hilmirstraum/hoytalerProsjekt/notater.txt

tid for pause signal å bli regristert 110 milisekund

tid fra min til maks volum 4,5 sekunder

rød: pins på arduino
sort: pinst på bluethooth
rød enkel: kcom 

kommandoer
volume:...
next song
last song
appConnected
appDisconnected
stop ip				forteller at man skal stoppe å vise ip addressen på skjermen

play: 4
vol-: 5
vol+: 6
DN: 7
UP: 8
