hilmirstraum/hoytalerProsjekt/koblingsskjema.pptx

Skjerm

SDA

SCL

VCC

GND

Forsterker

+

OUT1

GND

IN1

IN2

+

+

OUT2

Ultralydsensor

Trig

Vcc

Echo

Gnd

Arduino Uno

9

8

5

4

1

Aref

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
Ioref

Reset

3,3V

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
Bluethootkort

Lin

GND

Rin

NA

Lout

GND

Rout

NA

GND

+VCC

+5V

GND

MIC-

MIC+

NA

KEY COM

PLAY

VOL-

VOL+

DN

LED2

LED1

GND

UP

Nodemcu 1.0

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
