hilmirstraum/hoytalerProsjekt/(list of files, drawings)

Other design files:
Høytaler/schematik.fzz
schematik.fzz
