hilmirstraum/hoytalerProsjekt/(commit log)

2019-03-24 added høyttaler fil
    [deleliste.xlsx, høyaller altenativer.xlsx]
2019-03-27 skrevet kode for å kommunisere mellom arduino og nodemcu og laget en fil med litt info om hvordan bluethoothkortet leser inputer
    [schematik.fzz]
2019-03-28 endret test til å være en test av kombinasjonen ultralyd og lydjustering, endret litt på koden for å endre lyden sånn at den ikke bruker en delay men heler bruker millis til å se på tiden siden den s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
2019-03-31 la til all koden for serial kommunikasjon mellom arduinoen og nodemcuen
2019-03-31 la til funksjoner i arduinokoden for å skippe sang
    [deleliste.xlsx, høyaller altenativer.xlsx, schematik.fzz]
2019-04-02 slettet en del unødvendige filer
    [høyaller altenativer.xlsx, schematik.fzz]
2019-04-02 la inn skip sang og forrige sang samt korrigerte verdiene til de forskjellige pinsene.
    [arduinokode.ino]
2019-04-03 Oppdaterte koblingskjemaet sånn at det har med skipsong og lastsong. Kommenterte arduinokoden og oppdaterte setupen sånn at den har med pinMode for de nye pinsene. Endret også verdien for når det reg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
    [arduinokode.ino]
2019-04-03 skrev om skjermen på rapporten og lastet opp den siste versjonen av arduinoprogramet til arduinoen
2019-04-06 oppdaterte koblinsskjema med kabler for skip song og last song. Arduinokoden ble det ikke gjort noen endringer på
    [arduinokode.ino]
2019-04-15 rettet opp feilen med at to funksjoner hadde pin 5. Fjernet også at det er lys som lyser opp og endret det til en serial.println av volumet.
